WMBao/mulACS/mulACS-Report-Chn.pdf

## 基于蓝牙通讯与射频识别的寝室智能门禁系统设计

——《基于安卓开发平台的电子系统综合设计》课程报告

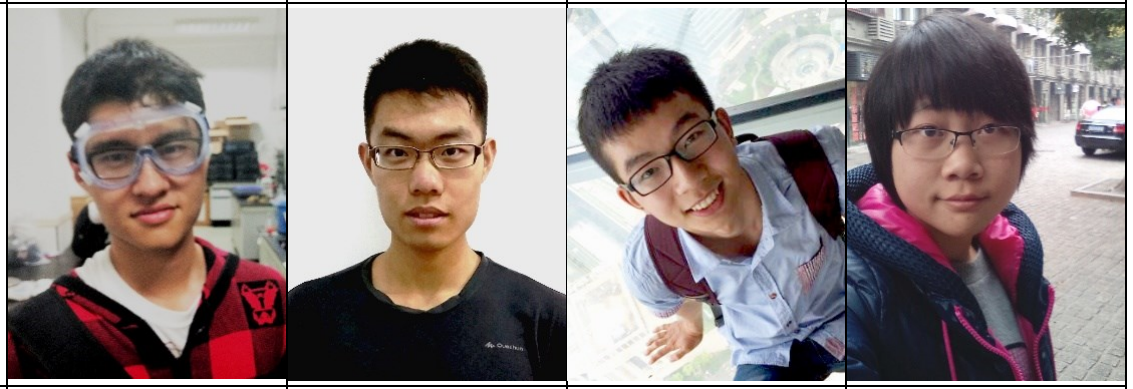
[picture p2: figure]

目 录

组号 | 六
姓名 | 包伟铭（组长） | 庞博 | 罗晶 | 林迪

照片

分工 | 安卓端蓝牙测试代 码，RFID、LCD 模 块调试，Arduino 端 代码，机械结构， 展示视频，课程报 告（完善+网页） | 蓝牙模块、舵机调 试，安卓端代码改 编，机械结构，展 示视频，课程报告 | 需求分析，功能设 计，机械结构， PPT，课程报告 | 需求分析，功能设 计，机械结构，课 程报告初稿

### 1. 项目介绍

### 1.1 项目背景

放眼身边，类似“有人敲门，室友不在而自己在床上”等情况下，开门

不便；出寝室忘带钥匙的囧境时有发生。就以上两类生活中的“痛点”，结合

课程内容，我们又想到手机和校园一卡通都不在身边的情况却少得多，故而

萌生了 DIY 设计基于蓝牙通讯与射频识别的安卓、Arduino 跨平台智能门禁

系统的想法，实现“刷卡开门”与“遥控开门”的功能。

### 1.2 实现方案

### 1.2.1 功能概述

功能需求 | 实现方案
刷卡开门 | 基于 RFID 射频模块，识别 IC 卡（校园卡，各类 S50， S70 卡等），实现卡号（UID）认证开门
遥控开门 | 基于蓝牙通讯，Android 终端与单片机间信息交换， 进而实现安卓 APP 按键开门

实现上述功能，门禁系统可分为电子系统（Arduino 平台系统

+Android 平台 APP）及机械系统两部分。

### 1.2.2 电子系统概览

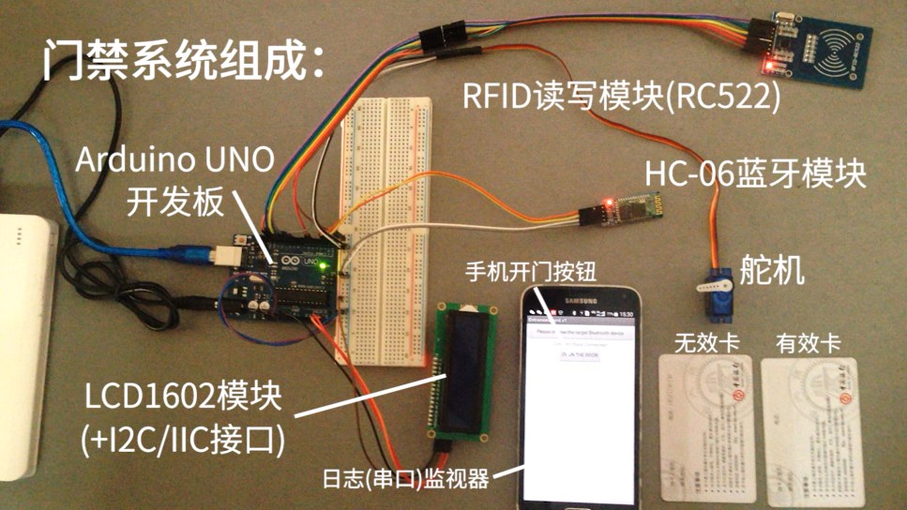
[picture p3: figure]

【图 1】门禁电子系统组成（DEMO 视频 1-桌面）

### 1.2.3 Arduino 平台系统

■ 硬件介绍

- Arduino UNO R3 单片机开发板

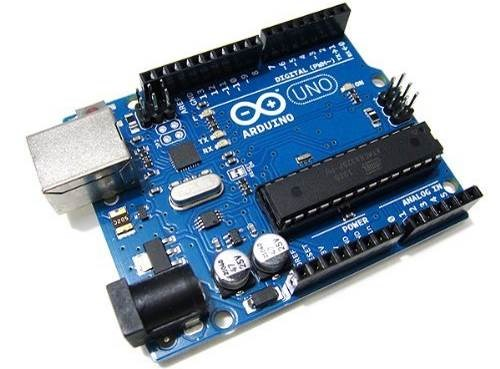
[picture p4: figure]

【图 2】Arduino UNO R3 开发板

电子系统使用 Arduino UNO R3 单片机开发平台。

本设计中单片机需要同时通过SPI连接RC522射频读写模块，通过I2C/IIC

总线接口连接 LCD1602 液晶模块，通过串口与蓝牙模块（Android 端）交互。

TI LaunchPad（MSP430G2553）开发板 SPI 数据接口与 I2C/IIC 总线接口复用，

而 Arduino UNO R3 不存在这一问题，无需分时复用，大大降低程序复杂度。

同时，Arduino 具有更为优秀、成熟的拓展性，可移植性。

- RFID-RC522 射频读写模块（SPI 接口）

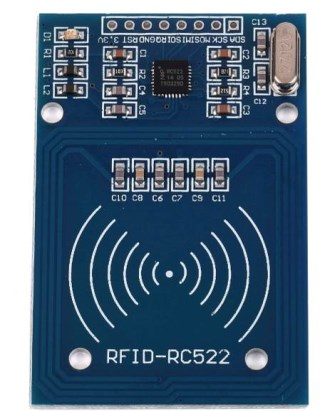
[picture p5: figure]

【图 3】RFID-RC522 射频读写模块

RFID-RC522 非接触式 IC 读写模块，支持遵循 ISO 14443A/ MIFARE®规

范的各类 IC 卡，常见如 S50 卡（校园卡，宾馆房卡，纽扣异形卡等），兼容标

准 SPI 接口。

SPI 接口通信以主从方式工作，通常有一个主设备和一个或多个从设备，

需要至少 4 根连接线（单向传输最少 3 根），分别是 SDI/MISO（主入从出）、

SDO/MOSI（主出从入）、SCL/K（时钟）、SS/CS（主从切换/片选）。

- LCD1602 液晶模块（I2C/IIC 总线接口）

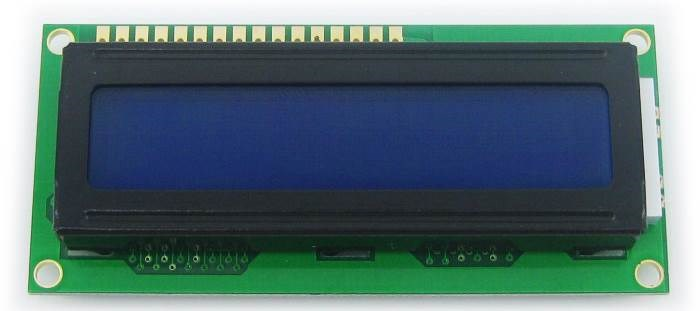
[picture p6: figure]

【图 4】LCD1602 液晶模块

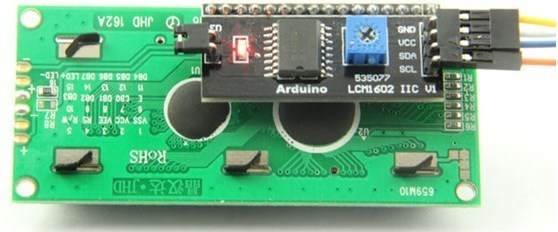
[picture p7: figure]

【图 5】1602 液晶 I2C/IIC 总线转接板

LCD1602 低功耗液晶模块可显示 16×2 个字符，内置 192 种字符（160

个 5×7 点阵字符和 32 个 5×10 点阵字符），具有 64 个字节的自定义字符

RAM，可自定义 8 个 5×8 点阵字符或四个 5×11 点阵字符。

I2C/IIC 是同步通信的一种特殊形式，通过串行数据（SDA）线和串行时

钟 （SCL）线在连接到总线的器件间传递信息，具有接口线少，控制方式简

单，器件封装形式小，通信速率较高等优点。

- HC-06 主从一体蓝牙模块

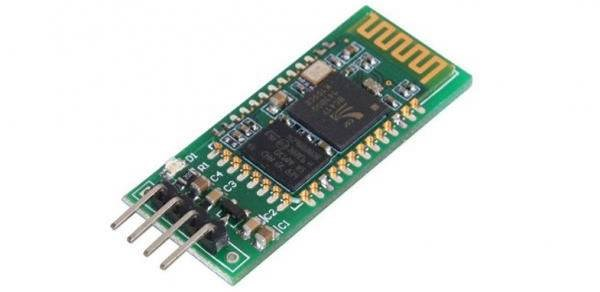
[picture p8: figure]

【图 6】HC-06 主从一体蓝牙模块

HC-06 主从一体蓝牙模块采用低成本、低功耗 CSR 芯片，支持蓝牙 v2.0

协议标准，可以实现终端在空旷环境下 10M 内通讯，使用广泛。

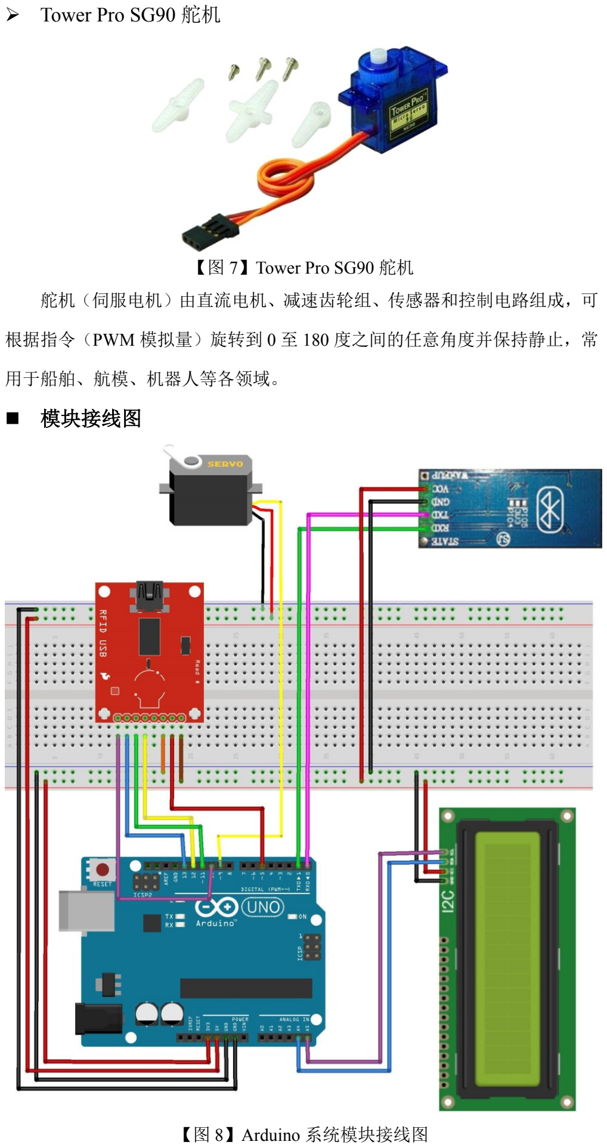
[picture p9: page 5]

- Tower Pro SG90 舵机

【图 7】Tower Pro SG90 舵机

舵机（伺服电机）由直流电机、减速齿轮组、传感器和控制电路组成，可

根据指令（PWM 模拟量）旋转到 0 至 180 度之间的任意角度并保持静止，常

用于船舶、航模、机器人等各领域。

■ 模块接线图

【图 8】Arduino 系统模块接线图

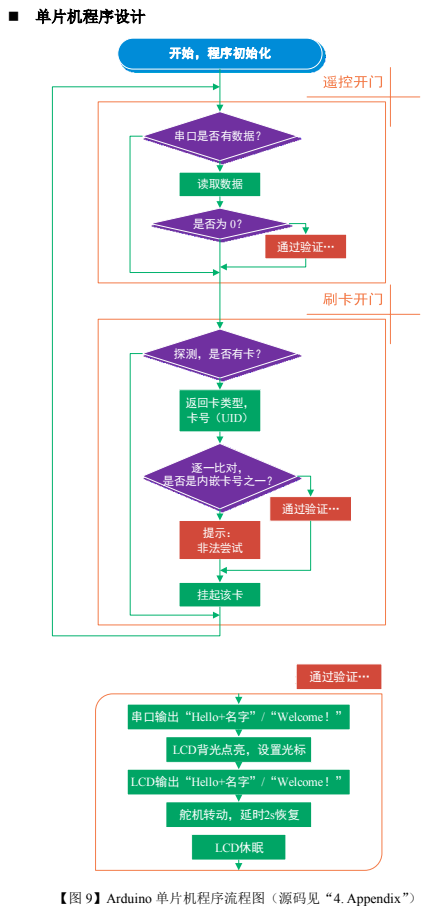
[picture p10: page 6]
单片机程序设计; 开始，程序初始化; 串口是否有数据？; 读取数据; 是否为 0？; 通过验证; 返回卡类型， 卡号（UID）; 探测，是否有卡？; 逐一比对， 是否是内嵌卡号之一？; 提示： 非法尝试; 挂起该卡; LCD背光点亮，设置光标; 舵机转动，延时2s恢复; LCD休眠

串口输出 Hello+名字 / Welcome！

LCD输出 Hello+名字 / Welcome！

【图 9】Arduino 单片机程序流程图（源码见“4. Appendix”）

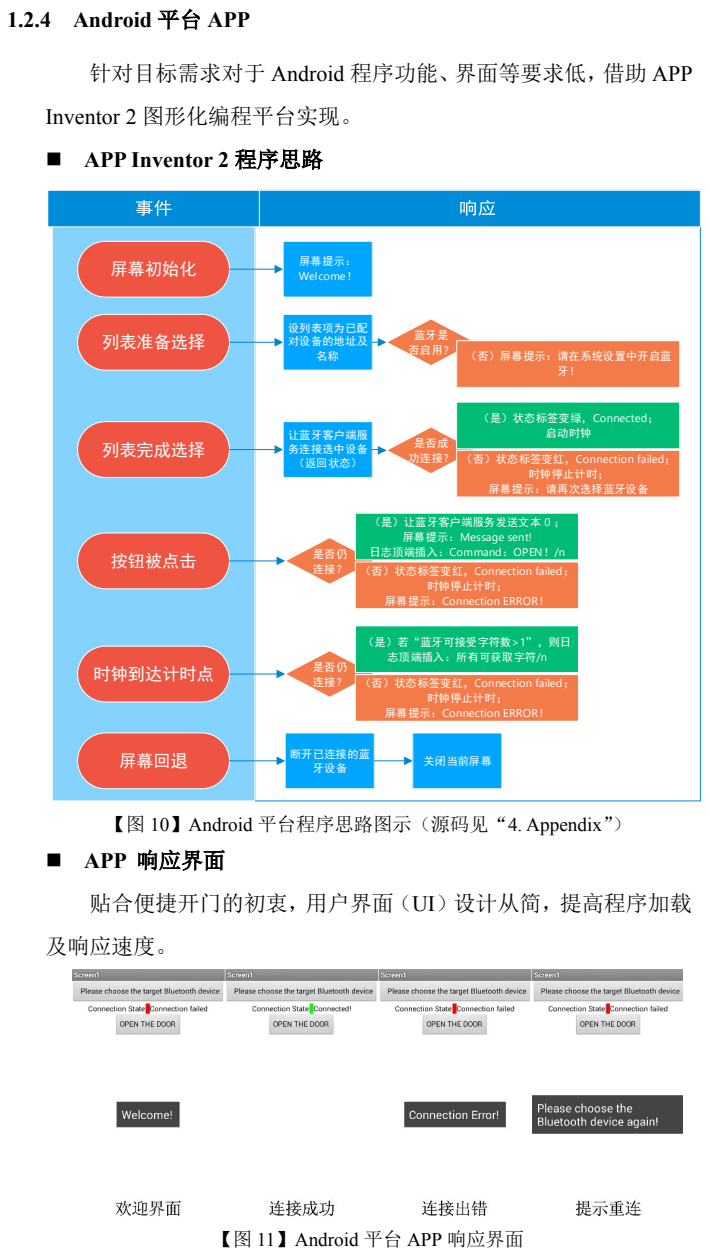
[picture p11: page 7]
Inventor 2 图形化编程平台实现。; APP Inventor 2 程序思路; 屏幕初始化; 屏幕回退; 列表准备选择; 列表完成选择; 按钮被点击; 时钟到达计时点; 屏幕提示： Welcome！; 断开已连接的蓝; 牙设备; 关闭当前屏幕; 设列表项为已配 对设备的地址及 名称; 让蓝牙客户端服 务连接选中设备 （返回状态）; 蓝牙是; 否启用？; （否）屏幕提示：请在系统设置中开启蓝; 是否仍; （否）状态标签变红，Connection failed；; 时钟停止计时；; （是）若 蓝牙可接受字符数>1 ，则日 志顶端插入：所有可获取字符/n; （是）让蓝牙客户端服务发送文本 0 ；; 是否成; 功连接？; 时钟停止计时； 屏幕提示：请再次选择蓝牙设备; （是）状态标签变绿，Connected； 启动时钟; APP 响应界面; 及响应速度。

1.2.4 Android 平台 APP

针对目标需求对于 Android 程序功能、界面等要求低，借助 APP

屏幕提示：Message sent!

日志顶端插入：Command：OPEN！/n

屏幕提示：Connection ERROR！

【图 10】Android 平台程序思路图示（源码见“4. Appendix”）

贴合便捷开门的初衷，用户界面（UI）设计从简，提高程序加载

【图 11】Android 平台 APP 响应界面

### 1.2.5 机械系统

综合考虑需求与实际情况，为降低改造难度，且不影响正常门内

转动开门、门外钥匙开锁，我们保留原有的门锁结构，确定了“舵机

驱动牵引门把手转动打开门锁”的设计思路。

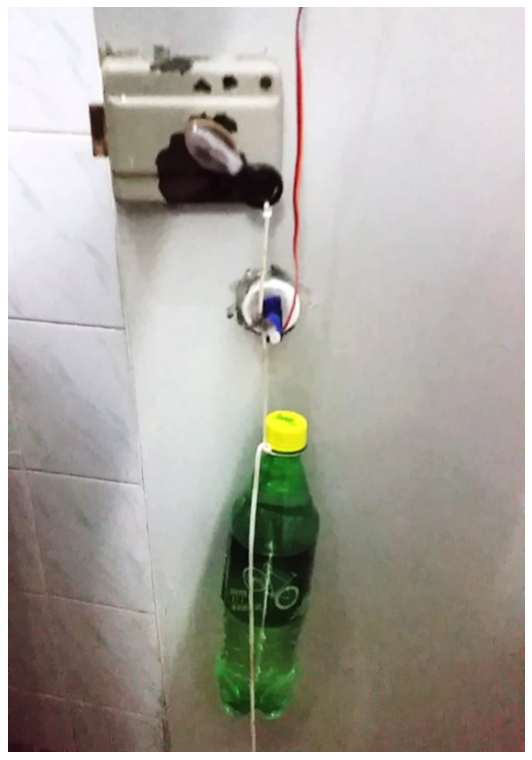
[picture p12: figure]

【图 12】“舵机-门锁”传动机械结构实拍图

■ | 寝室中实际测试效果见“1.3 项目成果-DEMO 视频 2-寝室”
■ | 实际测试中，我们针对发现的问题做了以下几点应对优化：
- 问题：门把手较小，门锁较老，转轴处阻力较大，不易转动；

✓ 应对：将一把钥匙用热熔胶固定在把手上，增大力臂，同时提供着力 点，方便绳索固定、拉动把手。

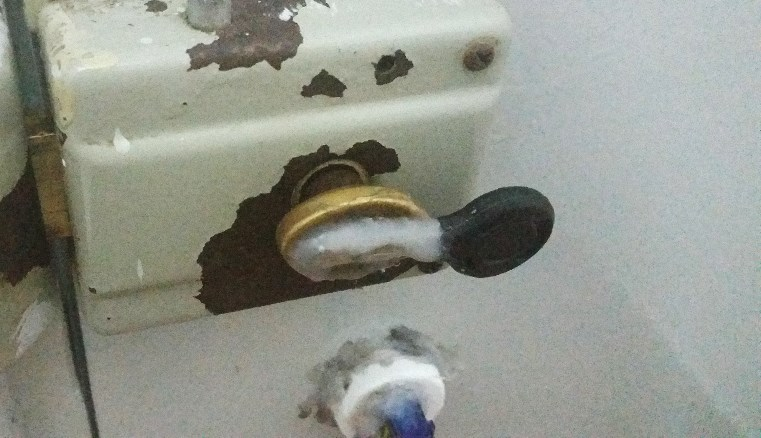
[picture p13: figure]

【图 13】门锁把手优化实拍图

- 问题：Tower Pro 舵机力量较小（实测 5v 时失速扭矩约<1.5kg/cm）；
✓ | 应对 1：悬挂配重：减少开锁过程锁把所需转动的最小角度，回避转动
| 时阻力最大的区域。（测试时方便调节重量，配重使用灌水饮料瓶）
✓ | 应对 2：舵机、绳索、把手相对位置设计：保证门锁死的前提下使初始
| 时更易拉动，最终状态更易达到保持。

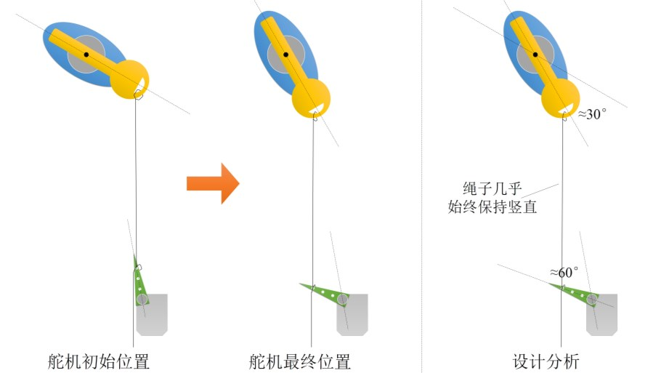
[picture p14: figure]

【图 14】舵机、绳索、把手相对位置设计示意图

### 1.3 项目成果

运动课程所学知识，完整实现刷卡开门、遥控开门两大预期功能，门禁

系统（电子系统+机械系统）经寝室实地调试试用可行。

- 电子系统详细功能演示视频见：DEMO 视频 1-桌面
- 寝室门禁实地完整演示视频见：DEMO 视频 2-寝室
功能 | 实现成果
刷卡开门 | 门外刷卡，RC522 模块读取 IC 卡的类型、卡号(UID)，与单 片机（Arduino）程序内预先嵌入的有效卡号比对。若卡认证 通过，则舵机转动带动门锁开门，LCD 显示“Hello+人 名”；若认证未通过，LCD 提示“Invalid Attempt”。
遥控开门 | 使用 App Inventor 设计开发安卓端 APP（兼容支持蓝牙 2.0 的各类安卓终端）。打开 APP 与单片机蓝牙模块配对完成 后，一键发送开门指令。单片机接收识别相关指令，控制舵 机转动开门。蓝牙连接状态下，手机端 APP 兼具日志监视器 功能，显示检测到 IC 卡的类型、卡号，指令及响应。

### 1.4 主要特色：

1) 无需另备相关 IC 卡，支持校园一卡通，方便忘带钥匙等情况；
2) 手机一键遥控开门，替代传统钥匙，切实符合现有需求，有实际应用

的价值意义；

3) 门禁系统没有对任何原有设施大规模改造，安装简易，无安全隐患；
4) Arduino 平台开发，就其维护便携，拓展功能成熟、强大的特点，该

系统后期进一步改进有极大的空间与可能。

### 1.5 改进设想：

1) 舵机对电流要求较大，为保护 Arduino 且改善现有充电宝供电电路

中供电电压不稳的情况，使用开关电源，外加基准源，5v 另供。

2) 现有机械传动装置美观性较为欠缺，可制作一个可套入门把手的模

具，使使用更美观可靠。同时改用 10g 以上扭矩较大的 Nano 舵机，

齿轮组传动。

3) 使用 Ethernet 拓展板，连入网络，实现对门状态的远程监视与控制。
4) 加入 4×4 按键键盘，实现远程生成访客密码开门功能。
5) 将蓝牙模块改成红外系统，编码库直接加载至现有的其他红外遥控

APP 中，如遥控精灵等；或单片机加设红外发射传感器，手机蓝牙

控制单片机经红外控制寝室空调等。实现寝室各器件的集成控制。

6) 智能寝室，单片机一并控制寝室电灯开关，风扇转速，窗帘开合等。

### 2. 收获体会

■ | 包伟铭（5140219191）
| 小学期课程期间，我们组运用课程相关知识，从日常生活切入，结合实
| 际，通过蓝牙通讯和 RFID 射频模块，成功实现具有刷校园卡控制寝室门打
| 开和安卓 APP 一键遥控功能的寝室智能门禁系统。
| 动手操作，体验尝试，仅是实现这些看似简单的功能，过程中仍会出现
| 许许多多意料之外的突发状况，前期反复论证心中再有底，到实际动手是仍
| 会出现或多或少的问题需要实践尝试去解决。我想这也是工程的魅力所在。

而只有潜下心，全情投入，面对种种出现的问题有恒心、毅力，不浮躁，轻

言放弃，最终才能在这最困难也是最有收获的阶段真正收获更多。

感谢组员们全情参与，在实现整个项目的过程中收获了一份记忆深刻的

体验，在相关理论、技术应用能力提高的过程中，更收获了许多兴奋与快乐！

■ | 庞博（5140219190） 小学期学习《基于安卓开发平台的电子综合平台的设计》这门课程，第 一次将编程应用在了解决实际需求之上——解决了躺在床上却有人敲门的尴 尬情景，出门忘带钥匙的不便情况。 实际成果的诞生给予了我们所有成员极大的成就感，提高了我学习编程 语言的积极性和自信心，让我感受到了编程与设计了乐趣。 总而言之，这门课上收获颇多，受益匪浅。
■ | 罗晶（5140219349） 经过这门课程的学习实践，我主要的感想是要对自己和队友有信心，不 要怀疑我们的能力。许多设想看似不可能完成，但通过大家的努力探究、方 案改善最终都能将想法变成现实。很多困难其实是纸老虎，比如刷校园卡开 门的实现，比如门锁机械装置的设计和动手安装过程。查阅资料、多动脑筋、 集思广益，方案最终也就实现了。 感谢小组成员的配合使最终项目成功完成，也感谢这个课让我对安卓平 台设计和应用更感兴趣，也使我积累了一定基础知识。
■ | 林迪（5140219186） 在课程学习中，我接触了 App Inventor 这一工具，学会了独立开发简易 APP；接触了 Arduino 单片机开发平台及部分模块的使用，学会了利用可视化 编程工具编程使单片机完成一些基础任务。 Arduino 和 Labview 有一定的相通之处，学起来很容易上手。故对我这样 的初级入门单片机和 APP 设计的学生而言，这门课是比较实用有效的。 在编写程序过程中，我学会了利用相关网站和学习手册查找相关知识从 而自学熟悉相关软件的使用。在小组作业完成过程中，整个小组一起合作， 最终完成这一作品，在过程中感受到团队分工合作的重要性。

### 3. 参考资料

[1]. Arduino Uno Introduction. https://www.arduino.cc/en/Main/ArduinoBoardUno. [2015.7.29]

[2]. 分享 ARDUINO 各版本引脚图（2014 版）. http://www.geek-workshop.com/thread-11826-

1-1.html. (http://www.geek-workshop.com/thread-11826-1-1.html) [2014-12-4/2015-7-29]

[3]. MF-RC522 RFID 在 Arduino 中的读取-ChinaUnix 博客. http://blog.chinaunix.net/uid-

23686726-id-3444925.html. (http://blog.chinaunix.net/uid-23686726-id-3444925.html) [2012-12-20/2015-7-29]

[4]. SPI_ 百 度 百 科 . http://baike.baidu.com/link?url=ucB-8FJTuaPWIt_3k2ytmd8fgmMfpoj-

0EsYYif49C3tqyX1HYIyMEAdDWELlTx7CwHuhG4he6nS3r2OymqGOq. (http://baike.baidu.com/link) [2015-7-29]

[5]. I2C 协议解析| CSDN 博客. http://blog.csdn.net/g_salamander/article/details/8016698. [2012-

10-17/2015-7-29]

[6]. DIYer 修炼：舵机知识扫盲. http://www.guokr.com/article/5292/. [2011-01-17/2015-7-29]

[7]. SG90 Analog|Tower Pro. http://www.towerpro.com.tw/product/sg90-analog/. [2015-7-29]

[8]. 极 客 工 坊 -Arduino 精华 . http://www.geek-workshop.com/portal.php?mod=list&catid=1.

[2015-7-29]

[9]. Arduino 模块库文件自带 Example

[10].《基于安卓开发平台的电子系统综合设计》课件

### 4. 致谢

感谢《基于安卓开发平台的电子系统综合设计》课程张士文老师的教授指导。

感谢该门课程让我们获得这一份充实、有意义的学习体验。学习探索的过程

中，在实践能力、工程意识、团队协作、创新精神等方面都深感收获良多。

感谢小学期课程中小组成员积极参与、交流探讨，分工协作，共同进步。

### 5. Appendix

1. APP Inventor 工程文件（Android 端源码）-entranceGuard.aia
2. Android 端 APP 安装包-entranceGuard.apk
3. Arduino UNO 程序源码-entranceGuard.ino
