WMBao/mulACS/website/images/image002.jpg

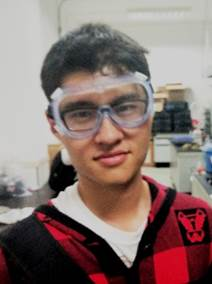
website/images/image002.jpg
