WMBao/mulACS/website/images/image004.jpg

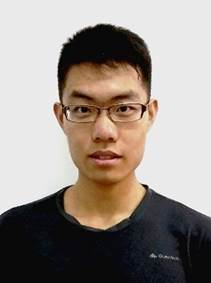
website/images/image004.jpg
