WMBao/mulACS/website/images/image006.jpg

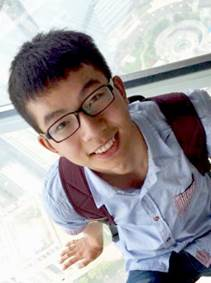
website/images/image006.jpg
