WMBao/mulACS/website/images/image008.jpg

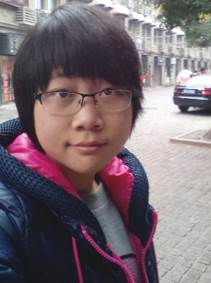
website/images/image008.jpg
