WMBao/mulACS/website/images/image022.jpg

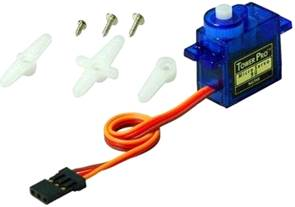
website/images/image022.jpg
