WMBao/mulACS/website/images/image026.png

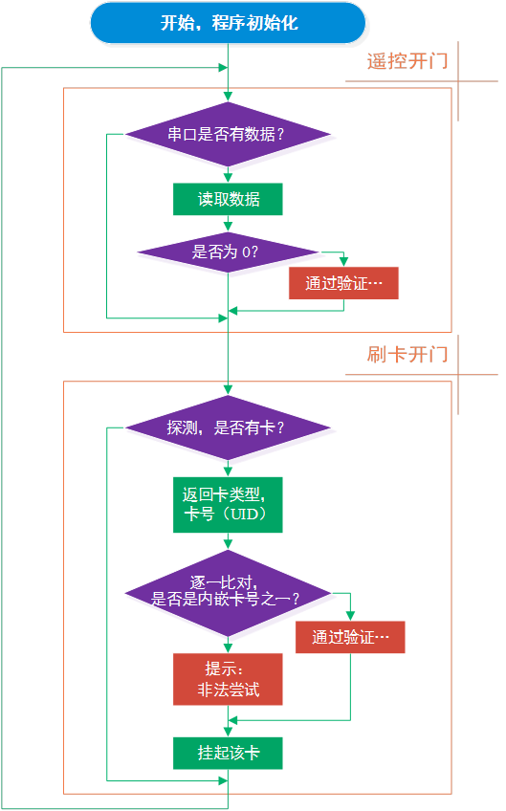
website/images/image026.png
