WMBao/mulACS/website/images/image027.png

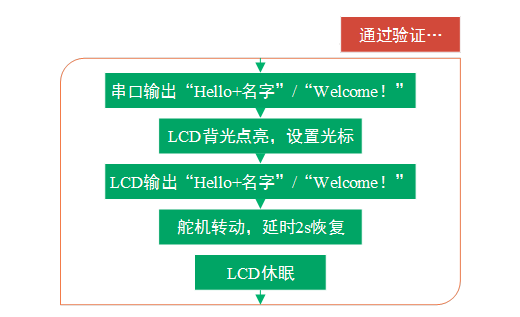
website/images/image027.png
