WMBao/mulACS/website/images/image029.png

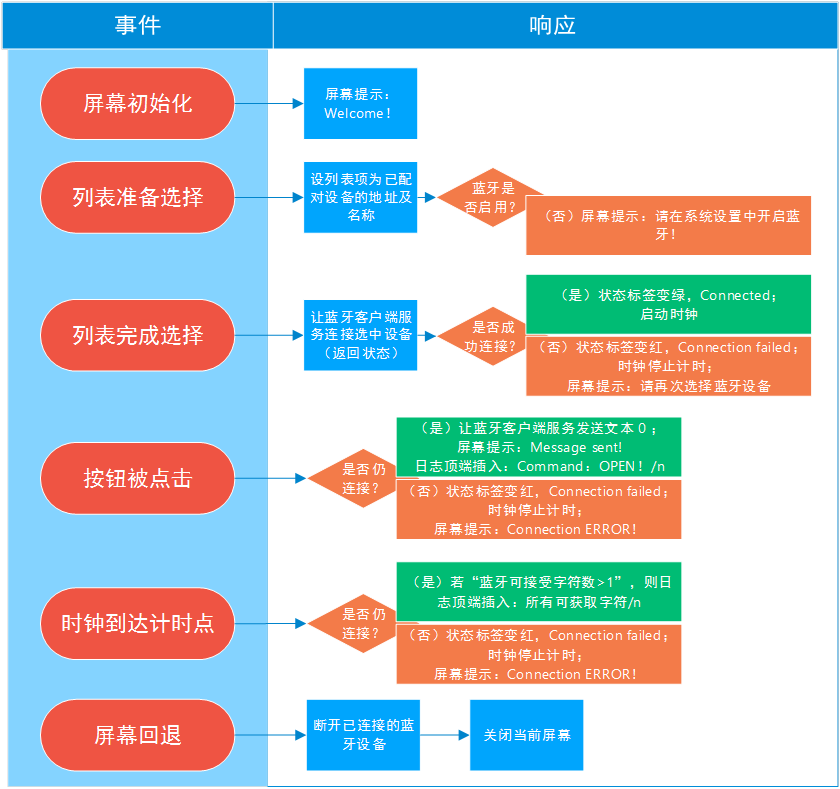
website/images/image029.png
