WMBao/mulACS/website/images/image031.jpg

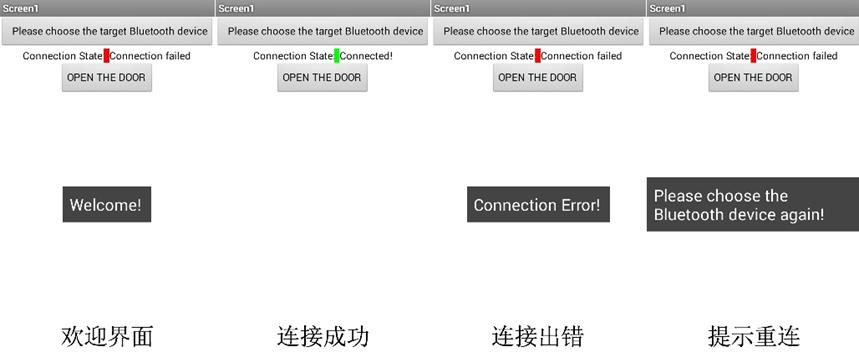
website/images/image031.jpg
