WMBao/mulACS/website/images/image033.png

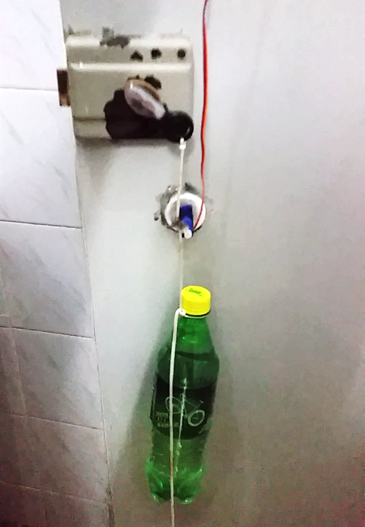
website/images/image033.png
