WMBao/mulACS/website/images/image037.png

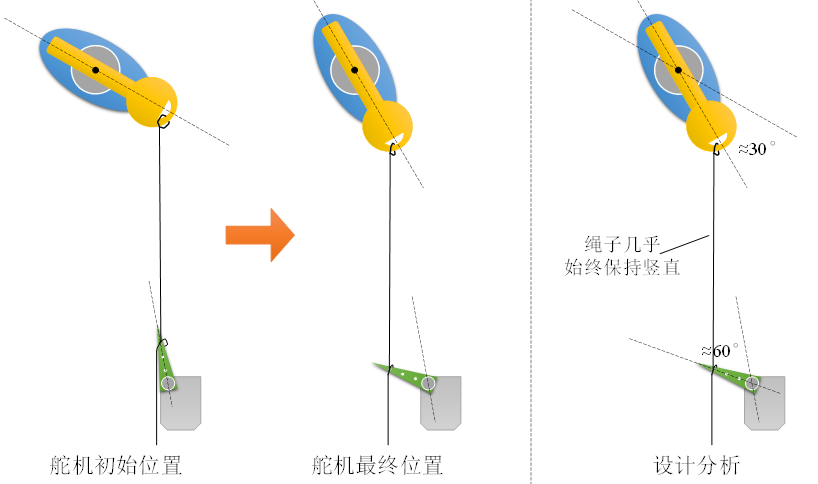
website/images/image037.png
